reinsdav/Thermometer_IR_v2/Thermometer_IR_v2/Thermometer_IR_v2.kicad_pcb

## KiCad design Thermometer_IR_v2/Thermometer_IR_v2.kicad_pcb (2023-04-21)

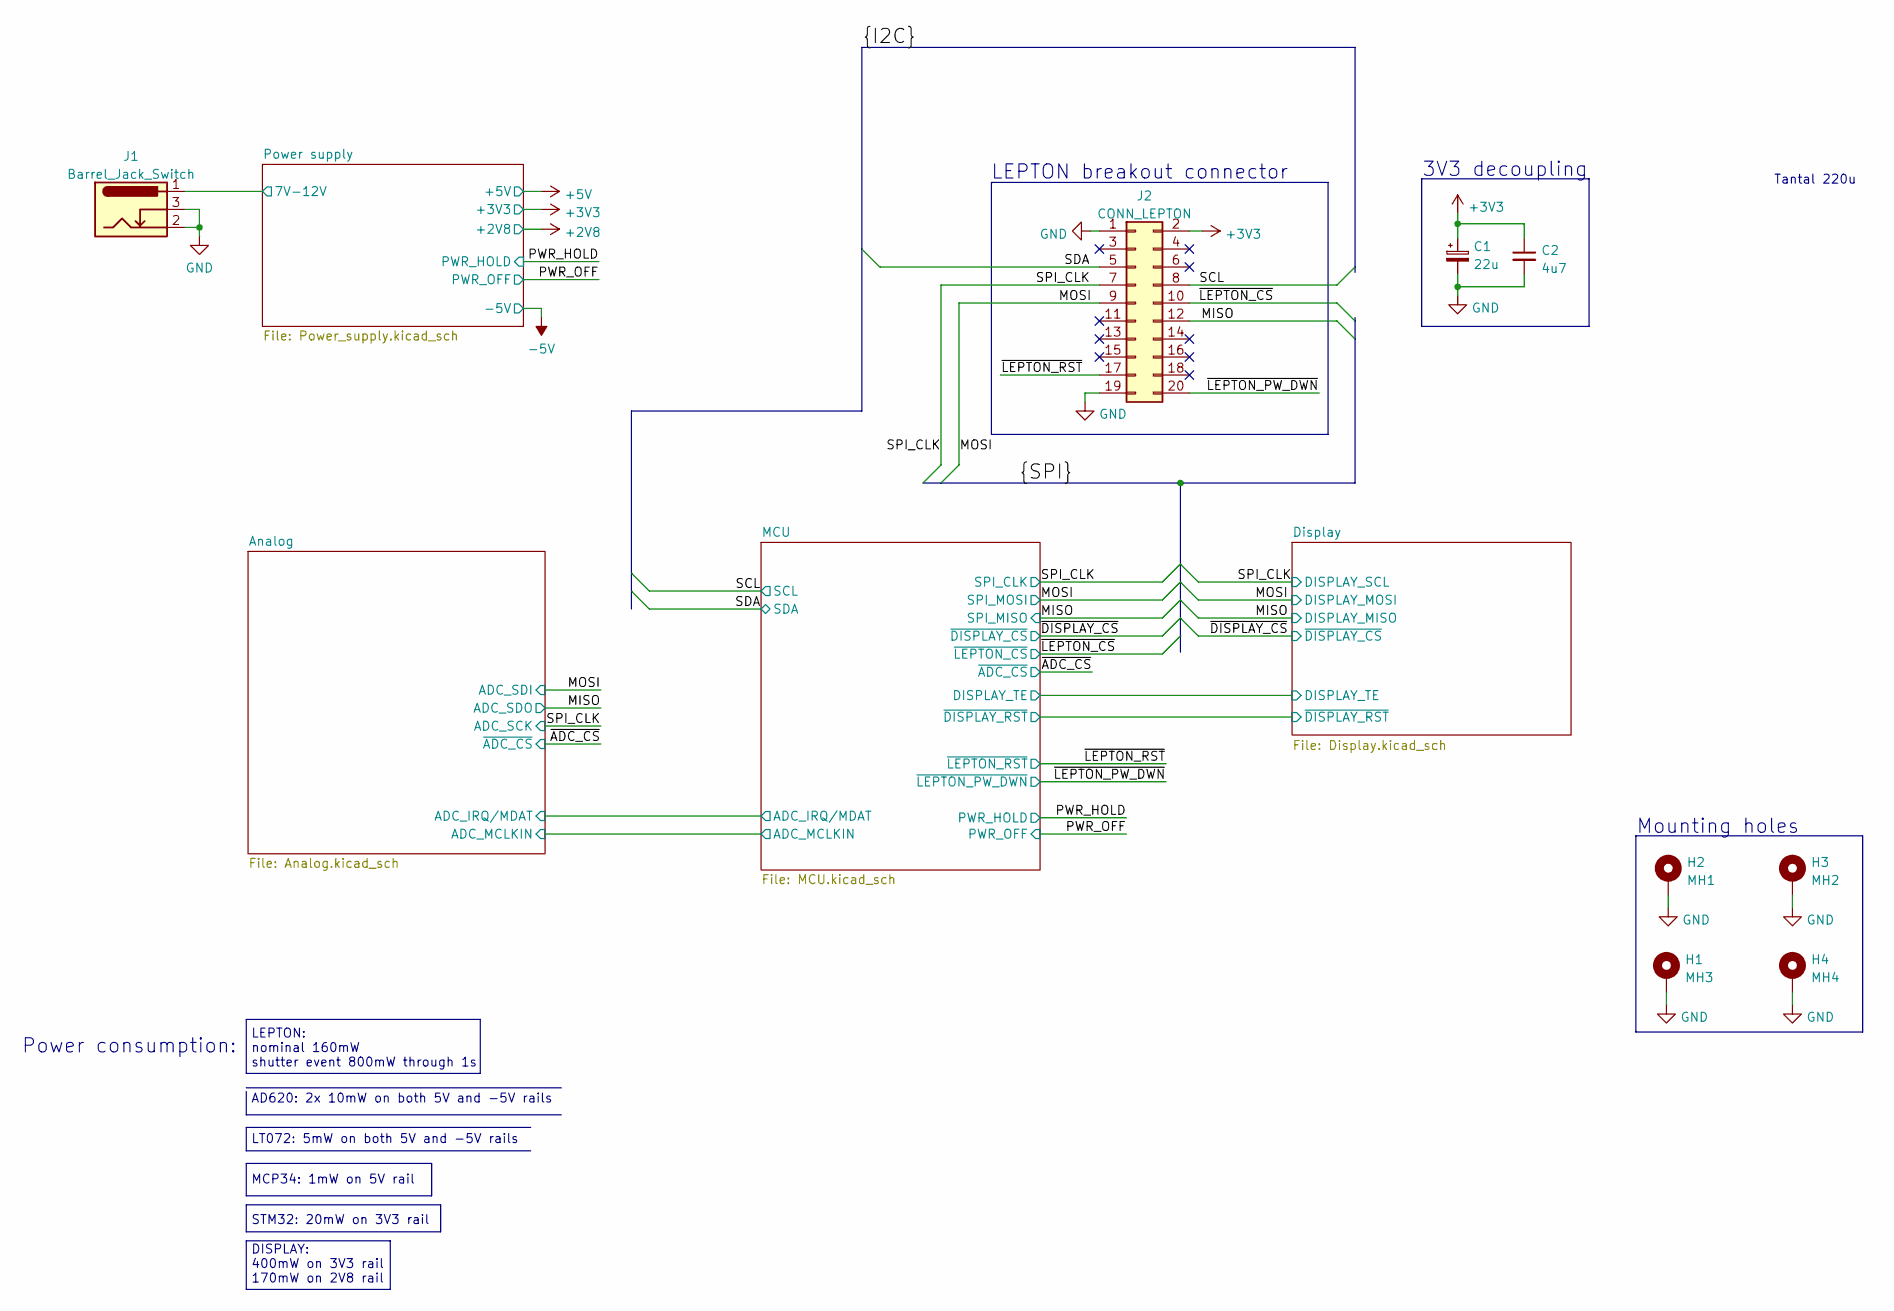
[picture p1: schematic Thermometer_IR_v2.kicad_sch, IR_Thermometer_&_Thermal_Camera]

Parts:
C1: 22u; CP_Elec_4x5.4
C2: 4u7; C_0805_2012Metric
H1: MH3; MountingHole_3mm_Pad_Via
H2: MH1; MountingHole_3mm_Pad_Via
H3: MH2; MountingHole_3mm_Pad_Via
H4: MH4; MountingHole_3mm_Pad_Via
J1: Barrel_Jack_Switch; BarrelJack_CLIFF_FC681465S_SMT_Horizontal
J2: CONN_LEPTON; PinSocket_2x10_P2.54mm_Horizontal

Connections:
+3V3: C1.1, C2.1, J2.2; also elsewhere on the board
/MISO: J2.12; also elsewhere on the board
/MOSI: J2.9; also elsewhere on the board
/Power supply/7V-12V: J1.1; also elsewhere on the board
/SCL: J2.8; also elsewhere on the board
/SDA: J2.5; also elsewhere on the board
/SPI_CLK: J2.7; also elsewhere on the board
/~LEPTON_CS: J2.10; also elsewhere on the board
/~LEPTON_PW_DWN: J2.20; also elsewhere on the board
/~LEPTON_RST: J2.17; also elsewhere on the board
GND: C1.2, C2.2, H1.1, H2.1, H3.1, H4.1, J1.2, J1.3, J2.1, J2.19; also elsewhere on the board

Notes on the sheet:
LT072: 5mW on both 5V and -5V rails
Power consumption:
STM32: 20mW on 3V3 rail
DISPLAY: 400mW on 3V3 rail 170mW on 2V8 rail
MCP34: 1mW on 5V rail
AD620: 2x 10mW on both 5V and -5V rails
3V3 decoupling
LEPTON breakout connector
Tantal 220u
LEPTON: nominal 160mW shutter event 800mW through 1s
Mounting holes

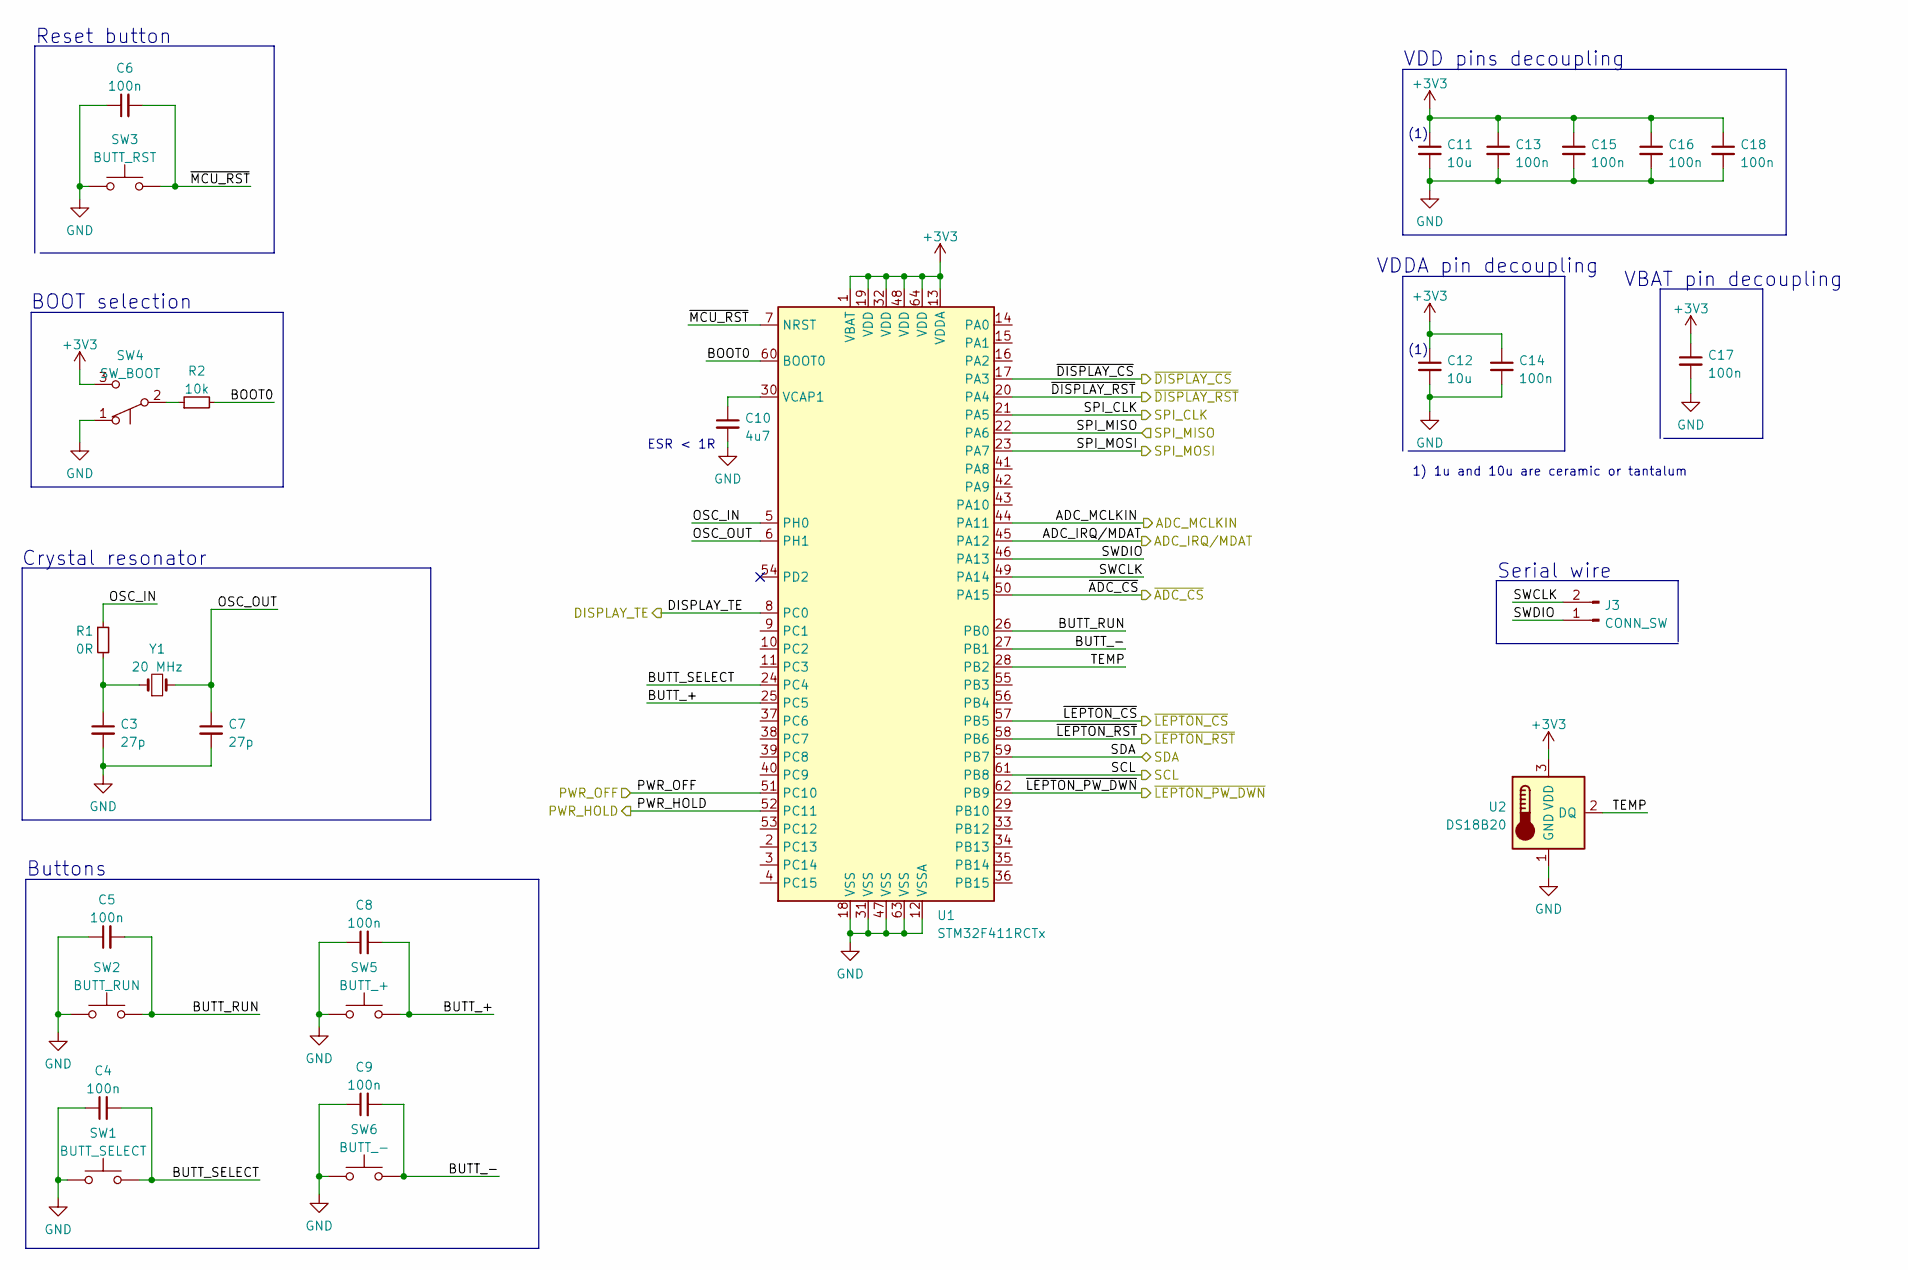
[picture p2: schematic MCU.kicad_sch, MCU_STM32]

Parts:
C3, C7: 27p; C_0805_2012Metric
C4, C5, C6, C8, C9, C13, C14, C15, C16, C17, C18: 100n; C_0805_2012Metric
C10: 4u7; C_0805_2012Metric
C11, C12: 10u; C_1206_3216Metric
J3: CONN_SW; PinHeader_1x02_P2.54mm_Vertical
R1: 0R; R_0805_2012Metric
R2: 10k; R_0805_2012Metric
SW1: BUTT_SELECT; SW_SPST_TL3305C
SW2: BUTT_RUN; SW_SPST_TL3305C
SW3: BUTT_RST; SW_SPST_TL3305C
SW4: SW_BOOT; SolderJumper-3_P1.3mm_Open_RoundedPad1.0x1.5mm_NumberLabels
SW5: BUTT_+; SW_SPST_TL3305C
SW6: BUTT_-; SW_SPST_TL3305C
U1: STM32F411RCTx; LQFP-64_10x10mm_P0.5mm
U2: DS18B20; TO-92_Inline
Y1: 20 MHz; Crystal_SMD_HC49-SD

Connections:
+3V3: C11.1, C12.1, C13.1, C14.1, C15.1, C16.1, C17.1, C18.1, SW4.3 (C), U1.1 (VBAT), U1.13 (VDDA), U1.19 (VDD), U1.32 (VDD), U1.48 (VDD), U1.64 (VDD), U2.3 (VDD); also elsewhere on the board
/Analog/ADC_IRQ/MDAT: U1.45 (PA12); also elsewhere on the board
/Analog/ADC_MCLKIN: U1.44 (PA11); also elsewhere on the board
/MCU/BOOT0: R2.2, U1.60 (BOOT0)
/MCU/BUTT_+: C8.2, SW5.2, U1.25 (PC5)
/MCU/BUTT_-: C9.2, SW6.2, U1.27 (PB1)
/MCU/BUTT_RUN: C5.2, SW2.2, U1.26 (PB0)
/MCU/BUTT_SELECT: C4.2, SW1.2, U1.24 (PC4)
/MCU/DISPLAY_TE: U1.8 (PC0); also elsewhere on the board
/MCU/OSC_IN: R1.1, U1.5 (PH0)
/MCU/OSC_OUT: C7.1, U1.6 (PH1), Y1.2
/MCU/SWCLK: J3.2, U1.49 (PA14)
/MCU/SWDIO: J3.1, U1.46 (PA13)
/MCU/TEMP: U1.28 (PB2), U2.2 (DQ)
/MCU/~DISPLAY_RST: U1.20 (PA4); also elsewhere on the board
/MCU/~MCU_RST: C6.2, SW3.2, U1.7 (NRST)
/MISO: U1.22 (PA6); also elsewhere on the board
/MOSI: U1.23 (PA7); also elsewhere on the board
/PWR_HOLD: U1.52 (PC11); also elsewhere on the board
/PWR_OFF: U1.51 (PC10); also elsewhere on the board
/SCL: U1.61 (PB8); also elsewhere on the board
/SDA: U1.59 (PB7); also elsewhere on the board
/SPI_CLK: U1.21 (PA5); also elsewhere on the board
/~ADC_CS: U1.50 (PA15); also elsewhere on the board
/~DISPLAY_CS: U1.17 (PA3); also elsewhere on the board
/~LEPTON_CS: U1.57 (PB5); also elsewhere on the board
/~LEPTON_PW_DWN: U1.62 (PB9); also elsewhere on the board
/~LEPTON_RST: U1.58 (PB6); also elsewhere on the board
GND: C3.2, C4.1, C5.1, C6.1, C7.2, C8.1, C9.1, C10.2, C11.2, C12.2, C13.2, C14.2, C15.2, C16.2, C17.2, C18.2, SW1.1, SW2.1, SW3.1, SW4.1 (A), SW5.1, SW6.1, U1.12 (VSSA), U1.18 (VSS), U1.31 (VSS), U1.47 (VSS), U1.63 (VSS), U2.1 (GND); also elsewhere on the board
unnamed: C3.1, R1.2, Y1.1
unnamed: C10.1, U1.30 (VCAP1)
unnamed: R2.1, SW4.2 (B)

Notes on the sheet:
Serial wire
VBAT pin decoupling
(1)
VDDA pin decoupling
1) 1u and 10u are ceramic or tantalum
BOOT selection
VDD pins decoupling
Buttons
Crystal resonator
Reset button
ESR < 1R

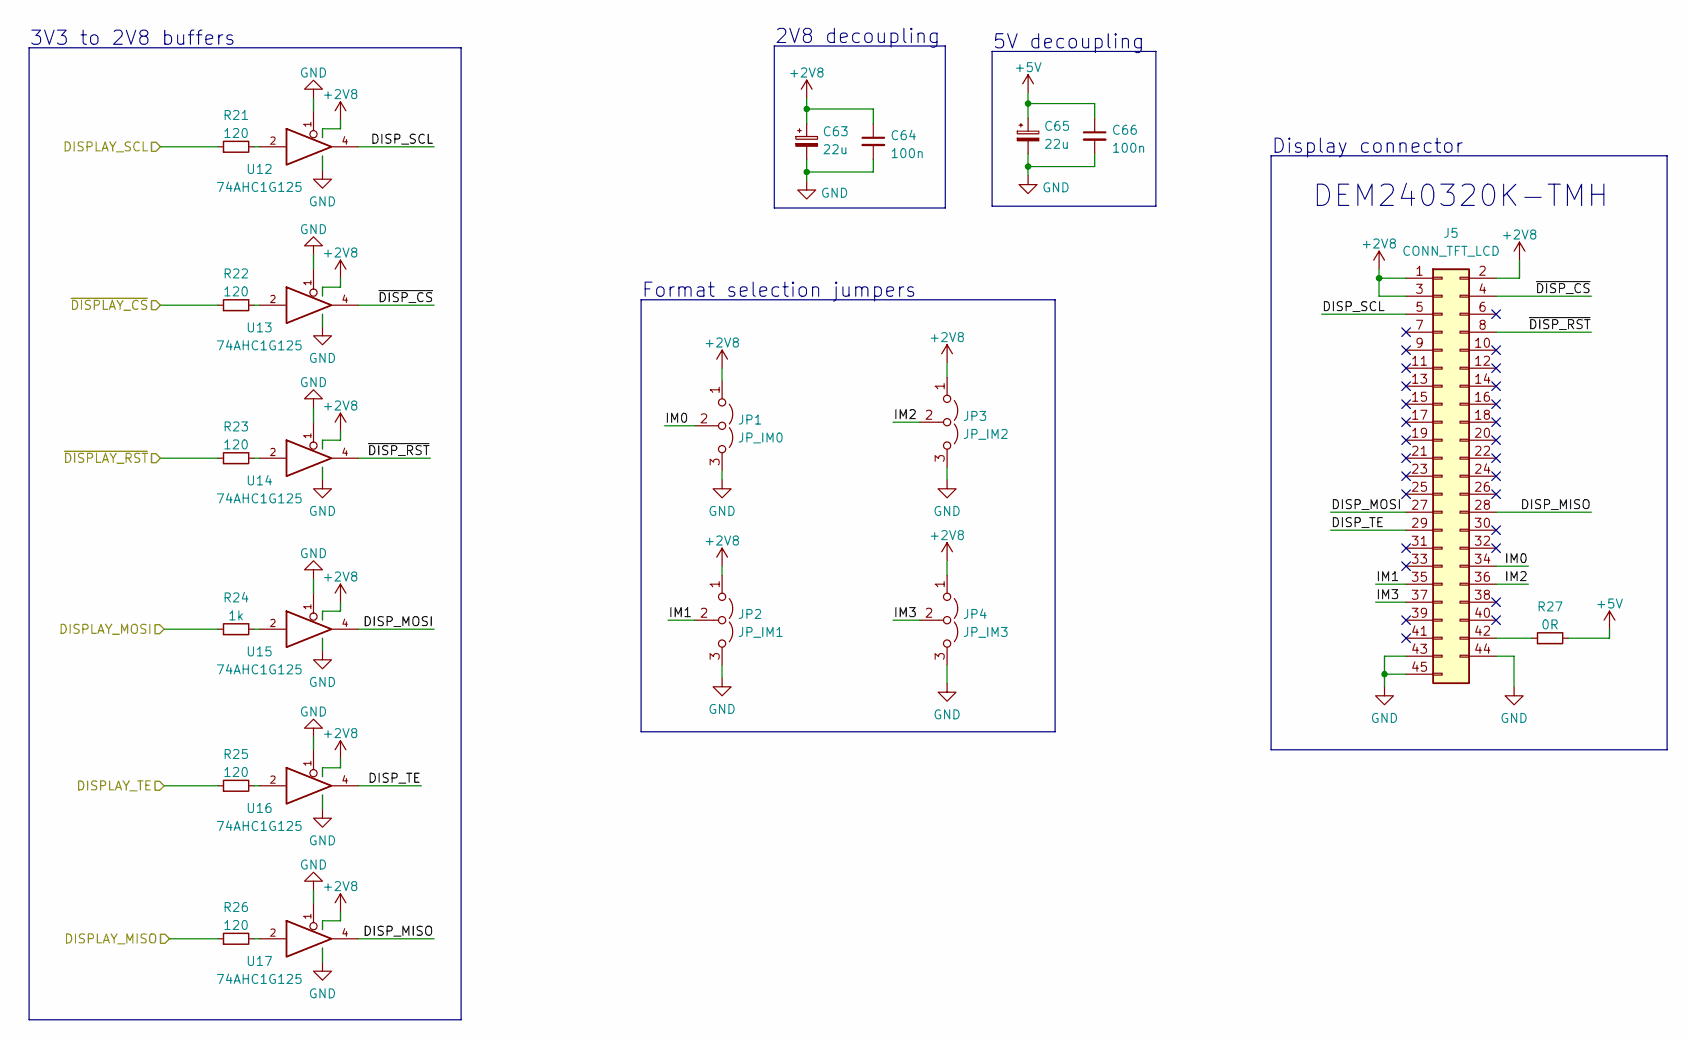
[picture p3: schematic Display.kicad_sch]

Parts:
C63, C65: 22u; CP_Elec_4x5.4
C64, C66: 100n; C_0805_2012Metric
J5: CONN_TFT_LCD; Hirose_FH12-45S-0.5SH_1x45-1MP_P0.50mm_Horizontal
JP1: JP_IM0; SolderJumper-3_P1.3mm_Open_RoundedPad1.0x1.5mm_NumberLabels
JP2: JP_IM1; SolderJumper-3_P1.3mm_Open_RoundedPad1.0x1.5mm_NumberLabels
JP3: JP_IM2; SolderJumper-3_P1.3mm_Open_RoundedPad1.0x1.5mm_NumberLabels
JP4: JP_IM3; SolderJumper-3_P1.3mm_Open_RoundedPad1.0x1.5mm_NumberLabels
R21, R22, R23, R25, R26: 120; R_0805_2012Metric
R24: 1k; R_0805_2012Metric
R27: 0R; R_0805_2012Metric
U12, U13, U14, U15, U16, U17: 74AHC1G125; SOT-353_SC-70-5

Connections:
+2V8: C63.1, C64.1, J5.1, J5.2, J5.3, JP1.1 (A), JP2.1 (A), JP3.1 (A), JP4.1 (A), U12.5 (VCC), U13.5 (VCC), U14.5 (VCC), U15.5 (VCC), U16.5 (VCC), U17.5 (VCC); also elsewhere on the board
+5V: C65.1, C66.1, R27.2; also elsewhere on the board
/Display/DISP_MISO: J5.28, U17.4
/Display/DISP_MOSI: J5.27, U15.4
/Display/DISP_SCL: J5.5, U12.4
/Display/DISP_TE: J5.29, U16.4
/Display/IM0: J5.34, JP1.2 (C)
/Display/IM1: J5.35, JP2.2 (C)
/Display/IM2: J5.36, JP3.2 (C)
/Display/IM3: J5.37, JP4.2 (C)
/Display/~DISP_CS: J5.4, U13.4
/Display/~DISP_RST: J5.8, U14.4
/MCU/DISPLAY_TE: R25.1; also elsewhere on the board
/MCU/~DISPLAY_RST: R23.1; also elsewhere on the board
/MISO: R26.1; also elsewhere on the board
/MOSI: R24.1; also elsewhere on the board
/SPI_CLK: R21.1; also elsewhere on the board
/~DISPLAY_CS: R22.1; also elsewhere on the board
GND: C63.2, C64.2, C65.2, C66.2, J5.43, J5.44, J5.45, JP1.3 (B), JP2.3 (B), JP3.3 (B), JP4.3 (B), U12.1, U12.3 (GND), U13.1, U13.3 (GND), U14.1, U14.3 (GND), U15.1, U15.3 (GND), U16.1, U16.3 (GND), U17.1, U17.3 (GND); also elsewhere on the board
unnamed: J5.42, R27.1
unnamed: R21.2, U12.2
unnamed: R22.2, U13.2
unnamed: R23.2, U14.2
unnamed: R24.2, U15.2
unnamed: R25.2, U16.2
unnamed: R26.2, U17.2

Notes on the sheet:
Display connector
DEM240320K-TMH
5V decoupling
Format selection jumpers
3V3 to 2V8 buffers
2V8 decoupling

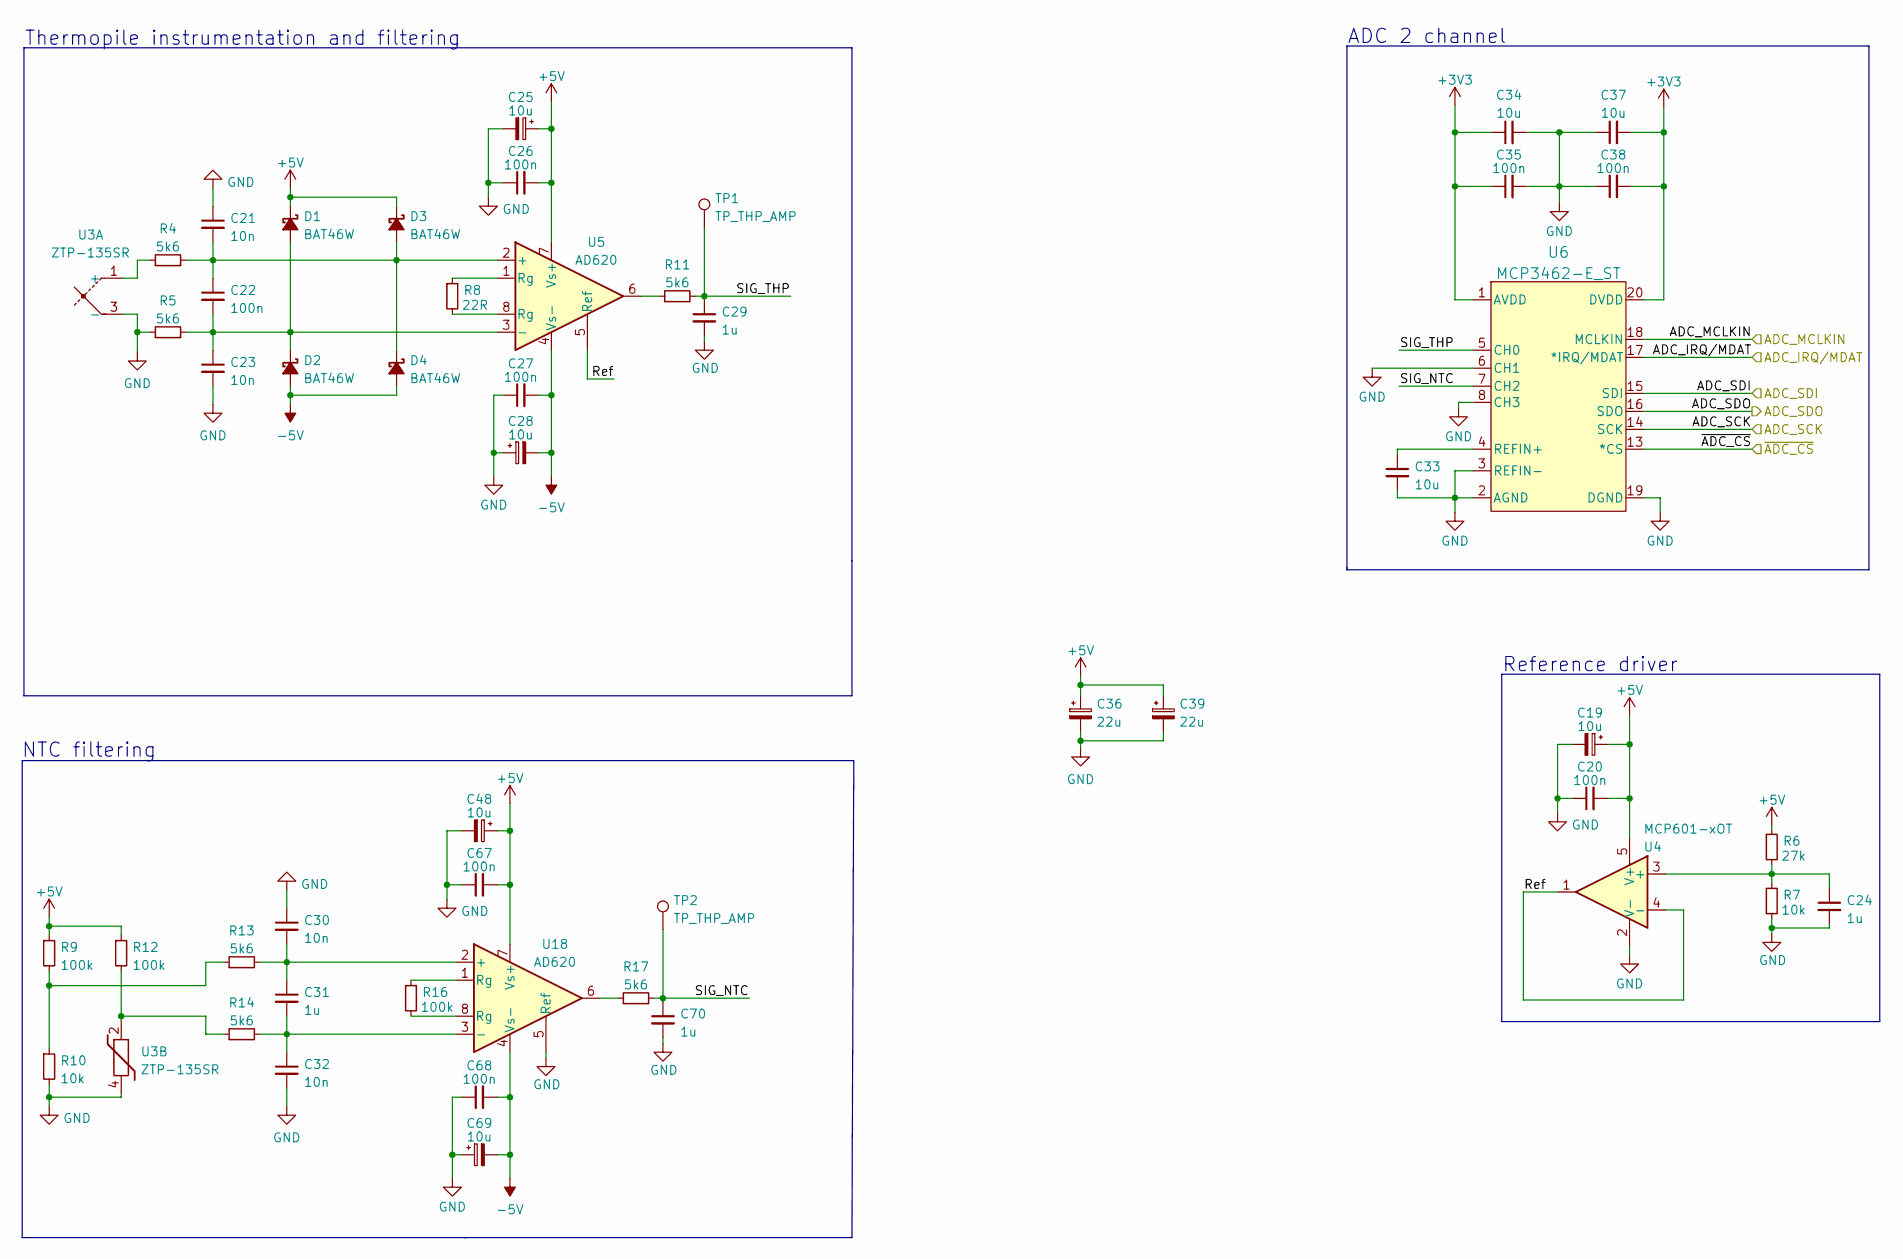
[picture p4: schematic Analog.kicad_sch]

Parts:
C19, C25, C28, C48, C69: 10u; C_1206_3216Metric
C20, C22, C26, C27, C35, C38, C67, C68: 100n; C_0805_2012Metric
C21, C23, C30, C32: 10n; C_0805_2012Metric
C24, C29, C31, C70: 1u; C_0805_2012Metric
C33, C34, C37: 10u; C_0805_2012Metric
C36, C39: 22u; CP_Elec_4x5.4
D1, D2, D3, D4: BAT46W; D_SOD-123F
R4, R5, R11, R13, R14, R17: 5k6; R_0805_2012Metric
R6: 27k; R_0805_2012Metric
R7, R10: 10k; R_0805_2012Metric
R8: 22R; R_0805_2012Metric
R9, R12, R16: 100k; R_0805_2012Metric
TP1, TP2: TP_THP_AMP; TestPoint_Pad_D2.0mm
U3: ZTP-135SR; TO-46-4
U4: MCP601-xOT; SOT-23-5
U5, U18: AD620; SOIC-8_3.9x4.9mm_P1.27mm
U6: MCP3462-E_ST; TSSOP-20_4.4x6.5mm_P0.65mm

Connections:
+3V3: C34.1, C35.1, C37.2, C38.2, U6.1 (AVDD), U6.20 (DVDD); also elsewhere on the board
+5V: C19.1, C20.2, C25.1, C26.2, C36.1, C39.1, C48.1, C67.2, D1.1 (K), D3.1 (K), R6.1, R9.1, R12.1, U4.5 (V+), U5.7 (Vs+), U18.7 (Vs+); also elsewhere on the board
-5V: C27.2, C28.2, C68.2, C69.2, D2.2 (A), D4.2 (A), U5.4 (Vs-), U18.4 (Vs-); also elsewhere on the board
/Analog/ADC_IRQ/MDAT: U6.17 (*IRQ/MDAT); also elsewhere on the board
/Analog/ADC_MCLKIN: U6.18 (MCLKIN); also elsewhere on the board
/Analog/Ref: U4.1, U4.4 (-), U5.5 (Ref)
/Analog/SIG_NTC: C70.1, R17.2, TP2.1, U6.7 (CH2)
/Analog/SIG_THP: C29.1, R11.2, TP1.1, U6.5 (CH0)
/MISO: U6.16 (SDO); also elsewhere on the board
/MOSI: U6.15 (SDI); also elsewhere on the board
/SPI_CLK: U6.14 (SCK); also elsewhere on the board
/~ADC_CS: U6.13 (*CS); also elsewhere on the board
GND: C19.2, C20.1, C21.1, C23.2, C24.2, C25.2, C26.1, C27.1, C28.1, C29.2, C30.1, C32.2, C33.2, C34.2, C35.2, C36.2, C37.1, C38.1, C39.2, C48.2, C67.1, C68.1, C69.1, C70.2, R5.1, R7.2, R10.2, U3.3 (-), U3.4, U4.2 (V-), U6.2 (AGND), U6.3 (REFIN-), U6.6 (CH1), U6.8 (CH3), U6.19 (DGND), U18.5 (Ref); also elsewhere on the board
unnamed: C21.2, C22.1, D3.2 (A), D4.1 (K), R4.2, U5.2 (+)
unnamed: C22.2, C23.1, D1.2 (A), D2.1 (K), R5.2, U5.3 (-)
unnamed: C24.1, R6.2, R7.1, U4.3 (+)
unnamed: C30.2, C31.1, R13.2, U18.2 (+)
unnamed: C31.2, C32.1, R14.2, U18.3 (-)
unnamed: C33.1, U6.4 (REFIN+)
unnamed: R4.1, U3.1 (+)
unnamed: R8.1, U5.1 (Rg)
unnamed: R8.2, U5.8 (Rg)
unnamed: R9.2, R10.1, R13.1
unnamed: R11.1, U5.6
unnamed: R12.2, R14.1, U3.2
unnamed: R16.1, U18.1 (Rg)
unnamed: R16.2, U18.8 (Rg)
unnamed: R17.1, U18.6

Notes on the sheet:
Reference driver
ADC 2 channel
Thermopile instrumentation and filtering
NTC filtering

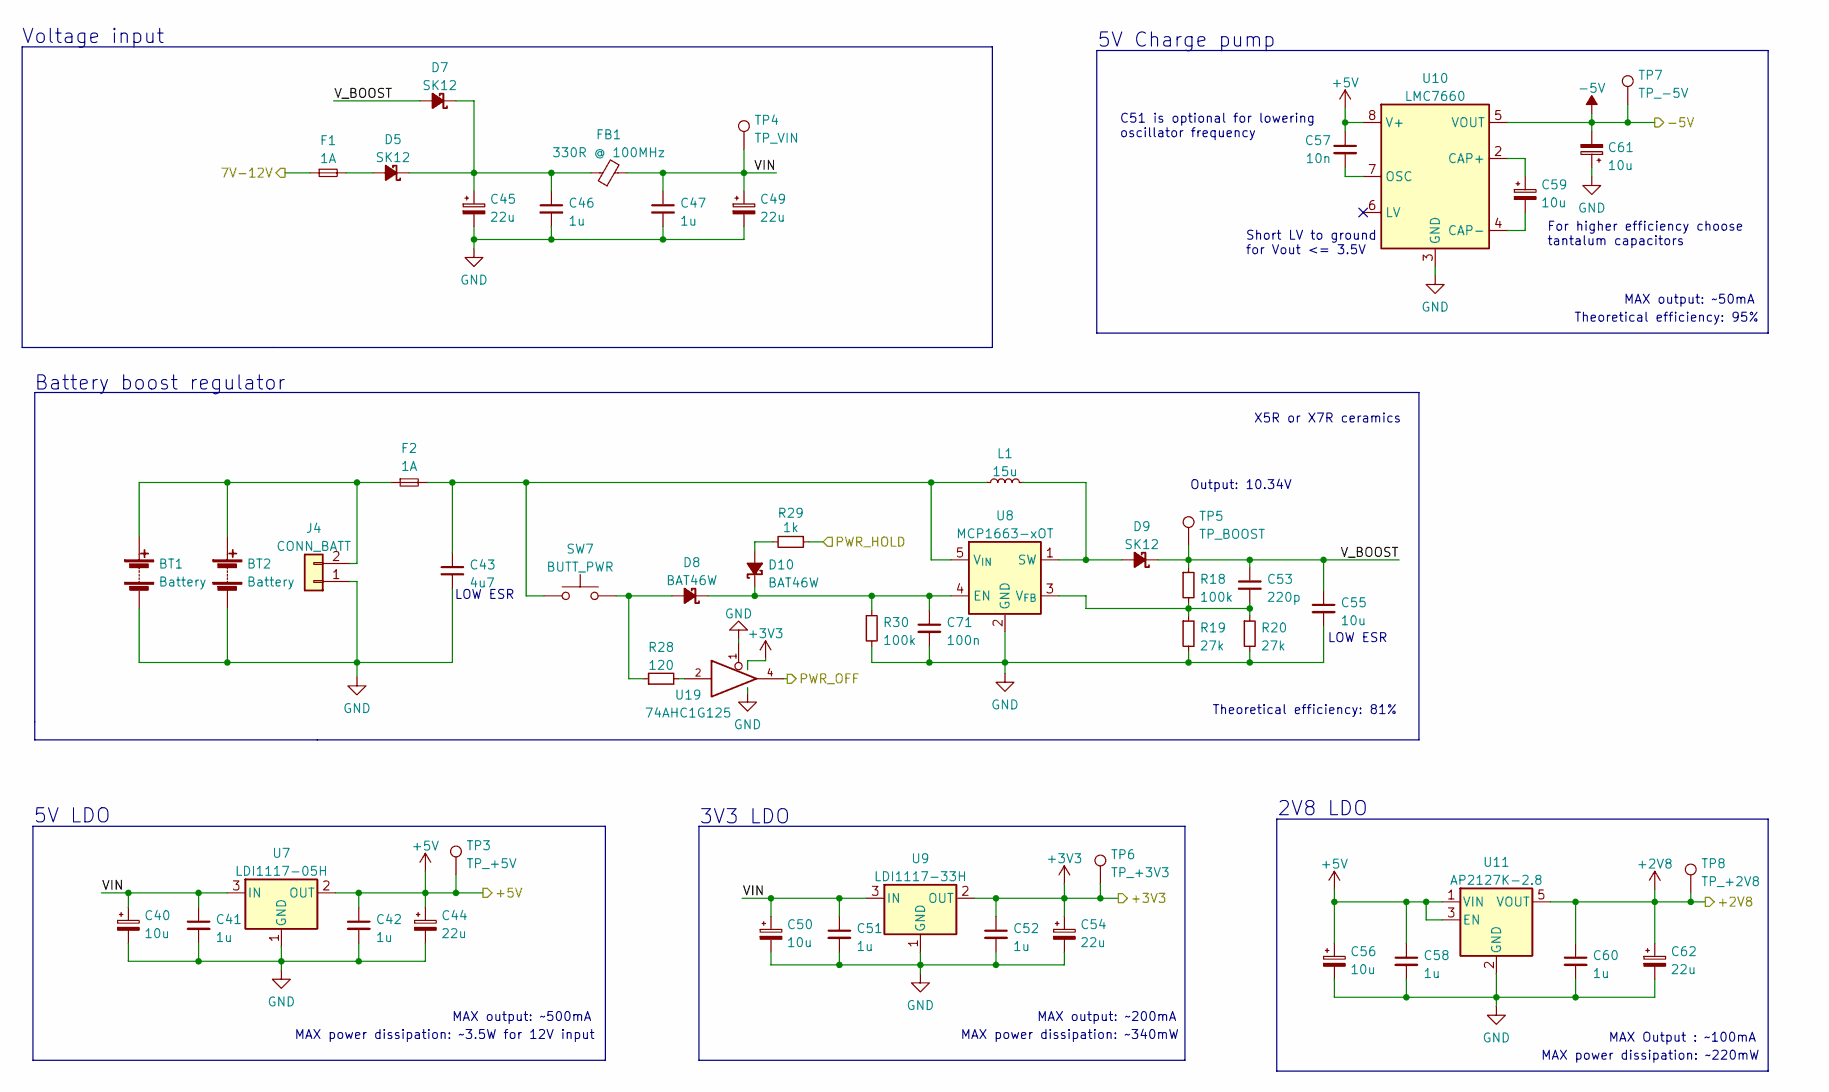
[picture p5: schematic Power_supply.kicad_sch, Power supply]

Parts:
BT1, BT2: Battery
C40, C50, C56, C59, C61: 10u; C_1206_3216Metric
C41, C42, C46, C47, C51, C52, C58, C60: 1u; C_0805_2012Metric
C43: 4u7; C_0805_2012Metric
C44, C54, C62: 22u; C_1206_3216Metric
C45, C49: 22u; CP_Elec_4x5.4
C53: 220p; C_0805_2012Metric
C55: 10u; C_0805_2012Metric
C57: 10n; C_0805_2012Metric
C71: 100n; C_0805_2012Metric
D5, D7, D9: SK12; D_SMA
D8, D10: BAT46W; D_SOD-123F
F1, F2: 1A; Fuse_1206_3216Metric
FB1: 330R @ 100MHz; L_0805_2012Metric
J4: CONN_BATT; TerminalBlock_bornier-2_P5.08mm
L1: 15u; L_7.3x7.3_H3.5
R18, R30: 100k; R_0805_2012Metric
R19, R20: 27k; R_0805_2012Metric
R28: 120; R_0805_2012Metric
R29: 1k; R_0805_2012Metric
SW7: BUTT_PWR; SW_SPST_TL3305C
TP3: TP_+5V; TestPoint_Pad_D2.0mm
TP4: TP_VIN; TestPoint_Pad_D2.0mm
TP5: TP_BOOST; TestPoint_Pad_D2.0mm
TP6: TP_+3V3; TestPoint_Pad_D2.0mm
TP7: TP_-5V; TestPoint_Pad_D2.0mm
TP8: TP_+2V8; TestPoint_Pad_D2.0mm
U7: LDI1117-05H; SOT-223
U8: MCP1663-xOT; SOT-23-5
U9: LDI1117-33H; SOT-223
U10: LMC7660; SOIC-8_3.9x4.9mm_P1.27mm
U11: AP2127K-2.8; SOT-23-5
U19: 74AHC1G125; SOT-353_SC-70-5

Connections:
+2V8: C60.1, C62.1, TP8.1, U11.5 (VOUT); also elsewhere on the board
+3V3: C52.1, C54.1, TP6.1, U9.2 (OUT), U9.4, U19.5 (VCC); also elsewhere on the board
+5V: C42.1, C44.1, C56.1, C57.1, C58.1, TP3.1, U7.2 (OUT), U7.4, U10.8 (V+), U11.1 (VIN), U11.3 (EN); also elsewhere on the board
-5V: C61.2, TP7.1, U10.5 (VOUT); also elsewhere on the board
/PWR_HOLD: R29.1; also elsewhere on the board
/PWR_OFF: U19.4; also elsewhere on the board
/Power supply/7V-12V: F1.1; also elsewhere on the board
/Power supply/VIN: C40.1, C41.1, C47.1, C49.1, C50.1, C51.1, FB1.2, TP4.1, U7.3 (IN), U9.3 (IN)
/Power supply/V_BOOST: C53.1, C55.1, D7.2 (A), D9.1 (K), R18.1, TP5.1
GND: BT1.2 (-), BT2.2 (-), C40.2, C41.2, C42.2, C43.2, C44.2, C45.2, C46.2, C47.2, C49.2, C50.2, C51.2, C52.2, C54.2, C55.2, C56.2, C58.2, C60.2, C61.1, C62.2, C71.2, J4.1, R19.2, R20.2, R30.2, U7.1 (GND), U8.2 (GND), U9.1 (GND), U10.3 (GND), U11.2 (GND), U19.1, U19.3 (GND); also elsewhere on the board
unnamed: BT1.1 (+), BT2.1 (+), F2.1, J4.2
unnamed: C43.1, F2.2, L1.1, SW7.1, U8.5 (V_{IN})
unnamed: C45.1, C46.1, D5.1 (K), D7.1 (K), FB1.1
unnamed: C53.2, R18.2, R19.1, R20.1, U8.3 (V_{FB})
unnamed: C57.2, U10.7 (OSC)
unnamed: C59.1, U10.2 (CAP+)
unnamed: C59.2, U10.4 (CAP-)
unnamed: D5.2 (A), F1.2
unnamed: D8.2 (A), R28.1, SW7.2
unnamed: D10.2 (A), R29.2
unnamed: D9.2 (A), L1.2, U8.1 (SW)
unnamed: R28.2, U19.2
unnamed: C71.1, D8.1 (K), D10.1 (K), R30.1, U8.4 (EN)

Notes on the sheet:
5V Charge pump
Battery boost regulator
2V8 LDO
MAX output: ~50mA
For higher efficiency choose tantalum capacitors
Short LV to ground for Vout <= 3.5V
MAX output: ~500mA
MAX output: ~200mA
Theoretical efficiency: 95%
5V LDO
LOW ESR
X5R or X7R ceramics
MAX power dissipation: ~3.5W for 12V input
C51 is optional for lowering oscillator frequency
MAX Output : ~100mA
Theoretical efficiency: 81%
Output: 10.34V
3V3 LDO
MAX power dissipation: ~340mW
Voltage input
MAX power dissipation: ~220mW

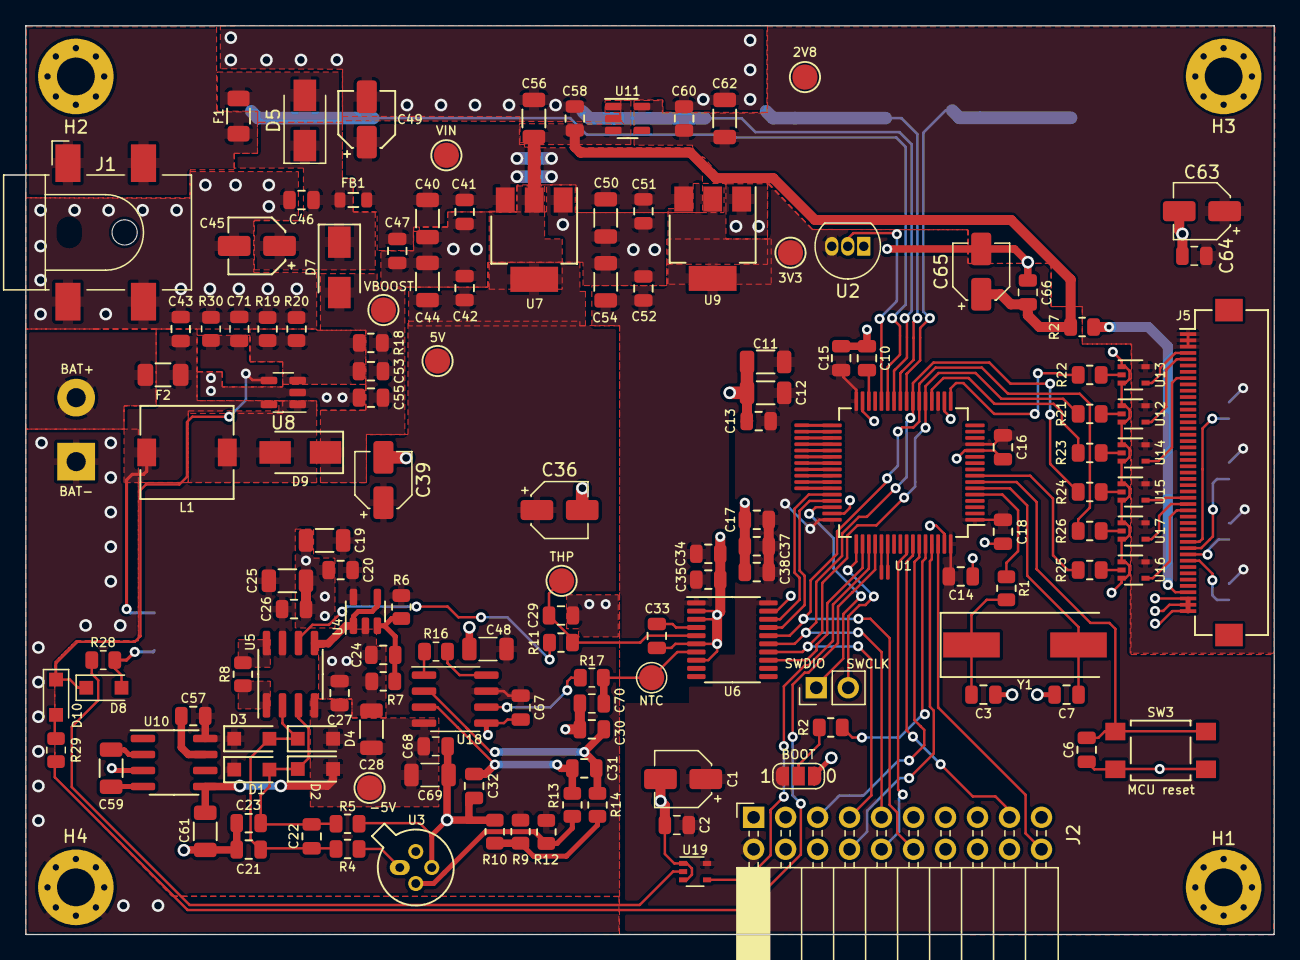
[picture p6: board Thermometer_IR_v2.kicad_pcb from above]

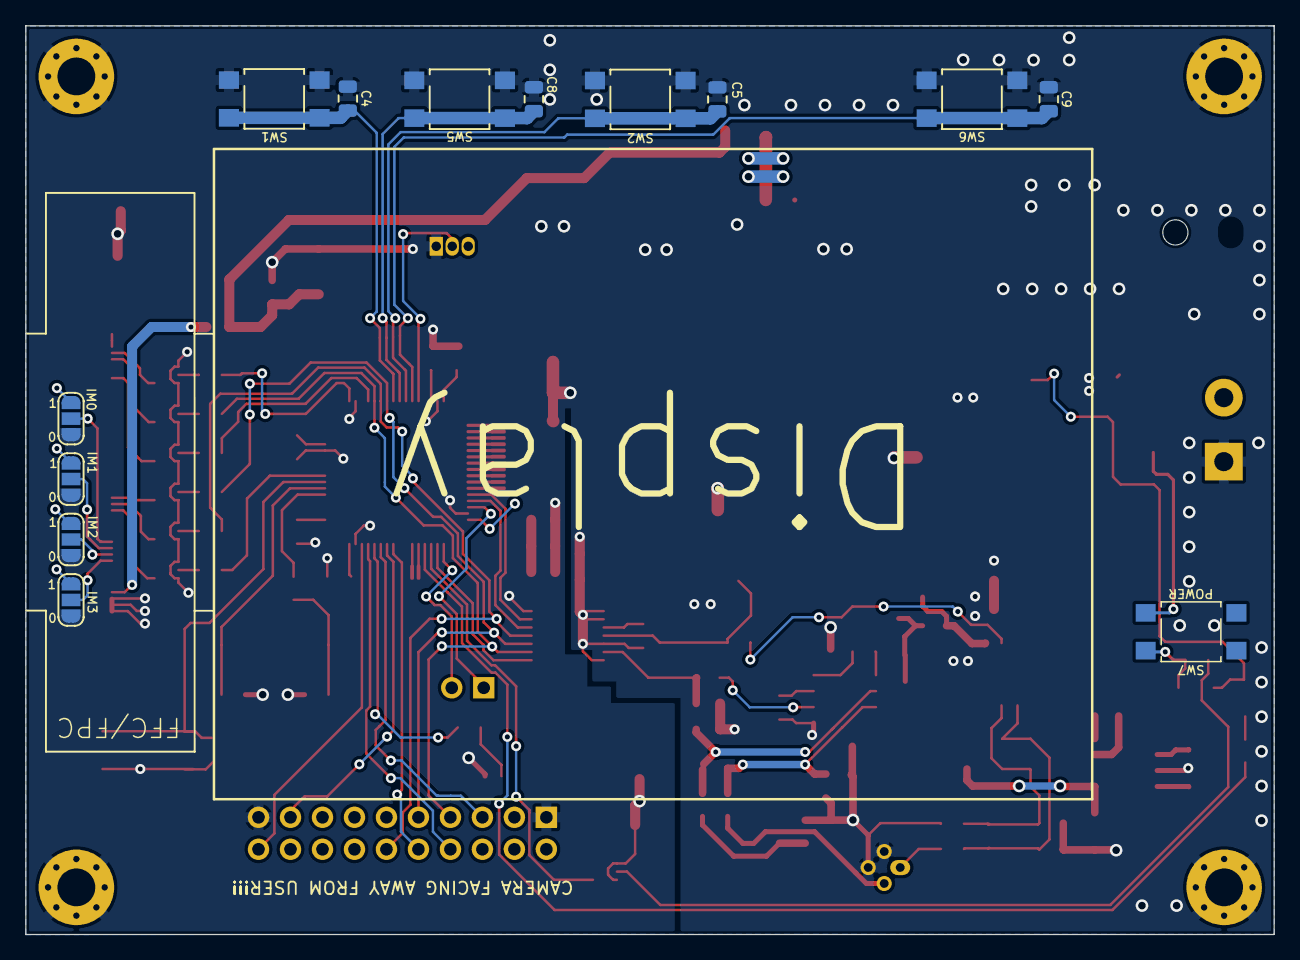
[picture p7: board Thermometer_IR_v2.kicad_pcb from below]

Board: 2 copper layers, 99.1 x 72.2 mm, 160 parts (13 on the bottom side), 86 nets.
